gmarcus1018/USBHUB/Models/FE1.1s.STEP

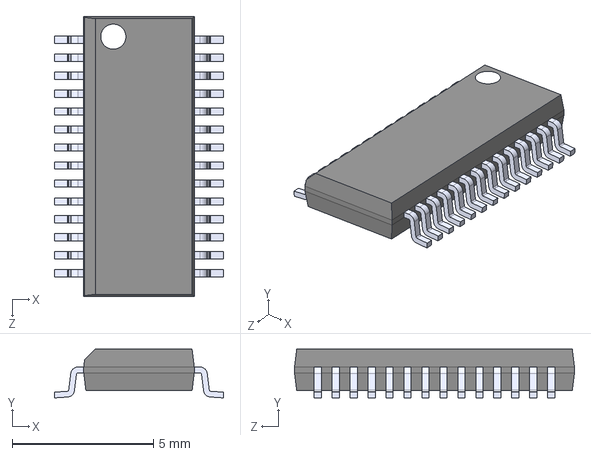
[picture p1: CAD file, 2026-06-26]
Models/FE1.1s.STEP
5.99 x 1.73 x 9.91 mm
