gmarcus1018/USBHUB/usbhub.step

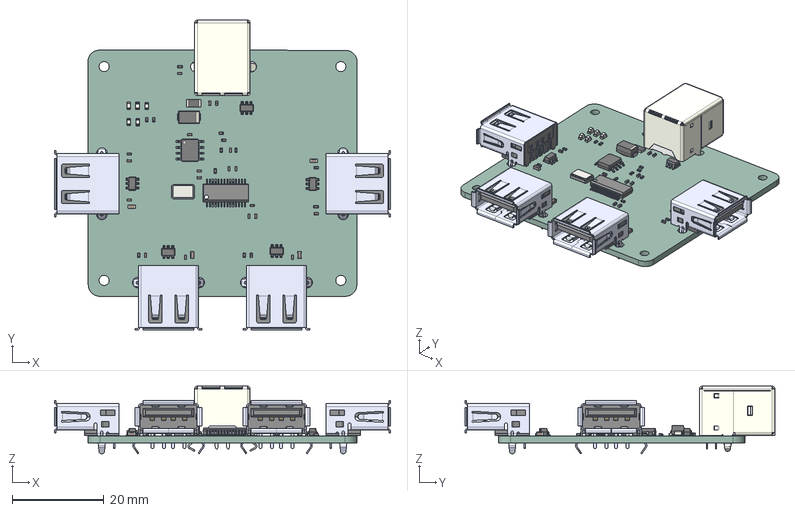
[picture p2: CAD file, 2026-06-26]
usbhub.step
73.1 x 67.4 x 14.7 mm
R_0402_1005Metric x 13
C_0402_1005Metric x 19
KUSBX-AS1N-B x 4
FE1.1S
C_0603_1608Metric x 4
SOT-23-6 x 5
LED_0603_1608Metric x 5
Fuse_1206_3216Metric
D_SMA
Crystal_SMD_Abracon_ABM3B-4Pin_5.0x3.2mm
CUI_DEVICES_UJ2-BH-W1-TH
SOIC-8-1EP_3.9x4.9mm_P1.27mm_EP2.29x3mm
usbhub_PCB
