gmarcus1018/USBHUB/Models/UJ2-BH-W1-TH.STEP

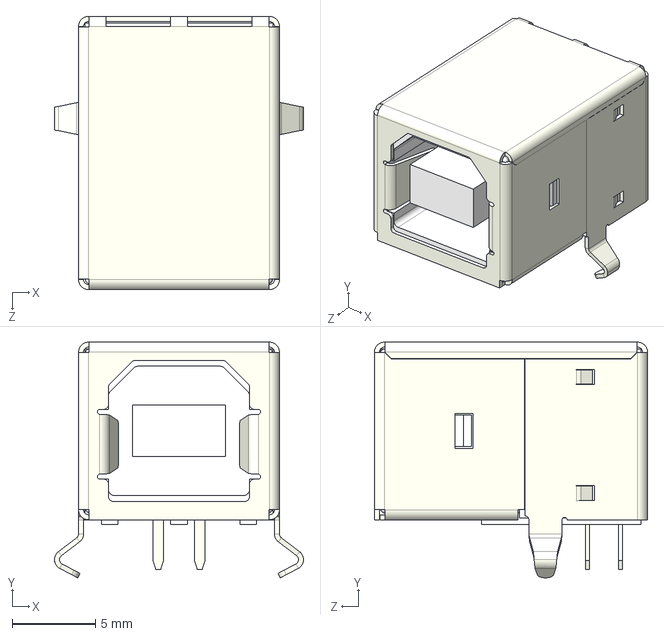
[picture p3: CAD file, 2026-06-26]
Models/UJ2-BH-W1-TH.STEP
15.0 x 14.2 x 16.5 mm
