gmarcus1018/USBHUB/Models/KUSBX-AS1N-B.STEP

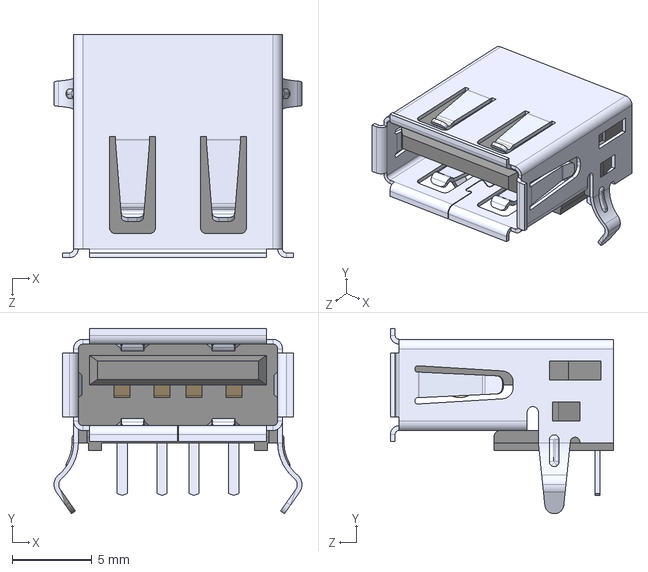
[picture p4: CAD file, 2026-06-26]
Models/KUSBX-AS1N-B.STEP
15.5 x 11.6 x 14.0 mm
