gmarcus1018/USBHUB/usbhub.kicad_pcb

## KiCad design usbhub.kicad_pcb (2026-06-26)

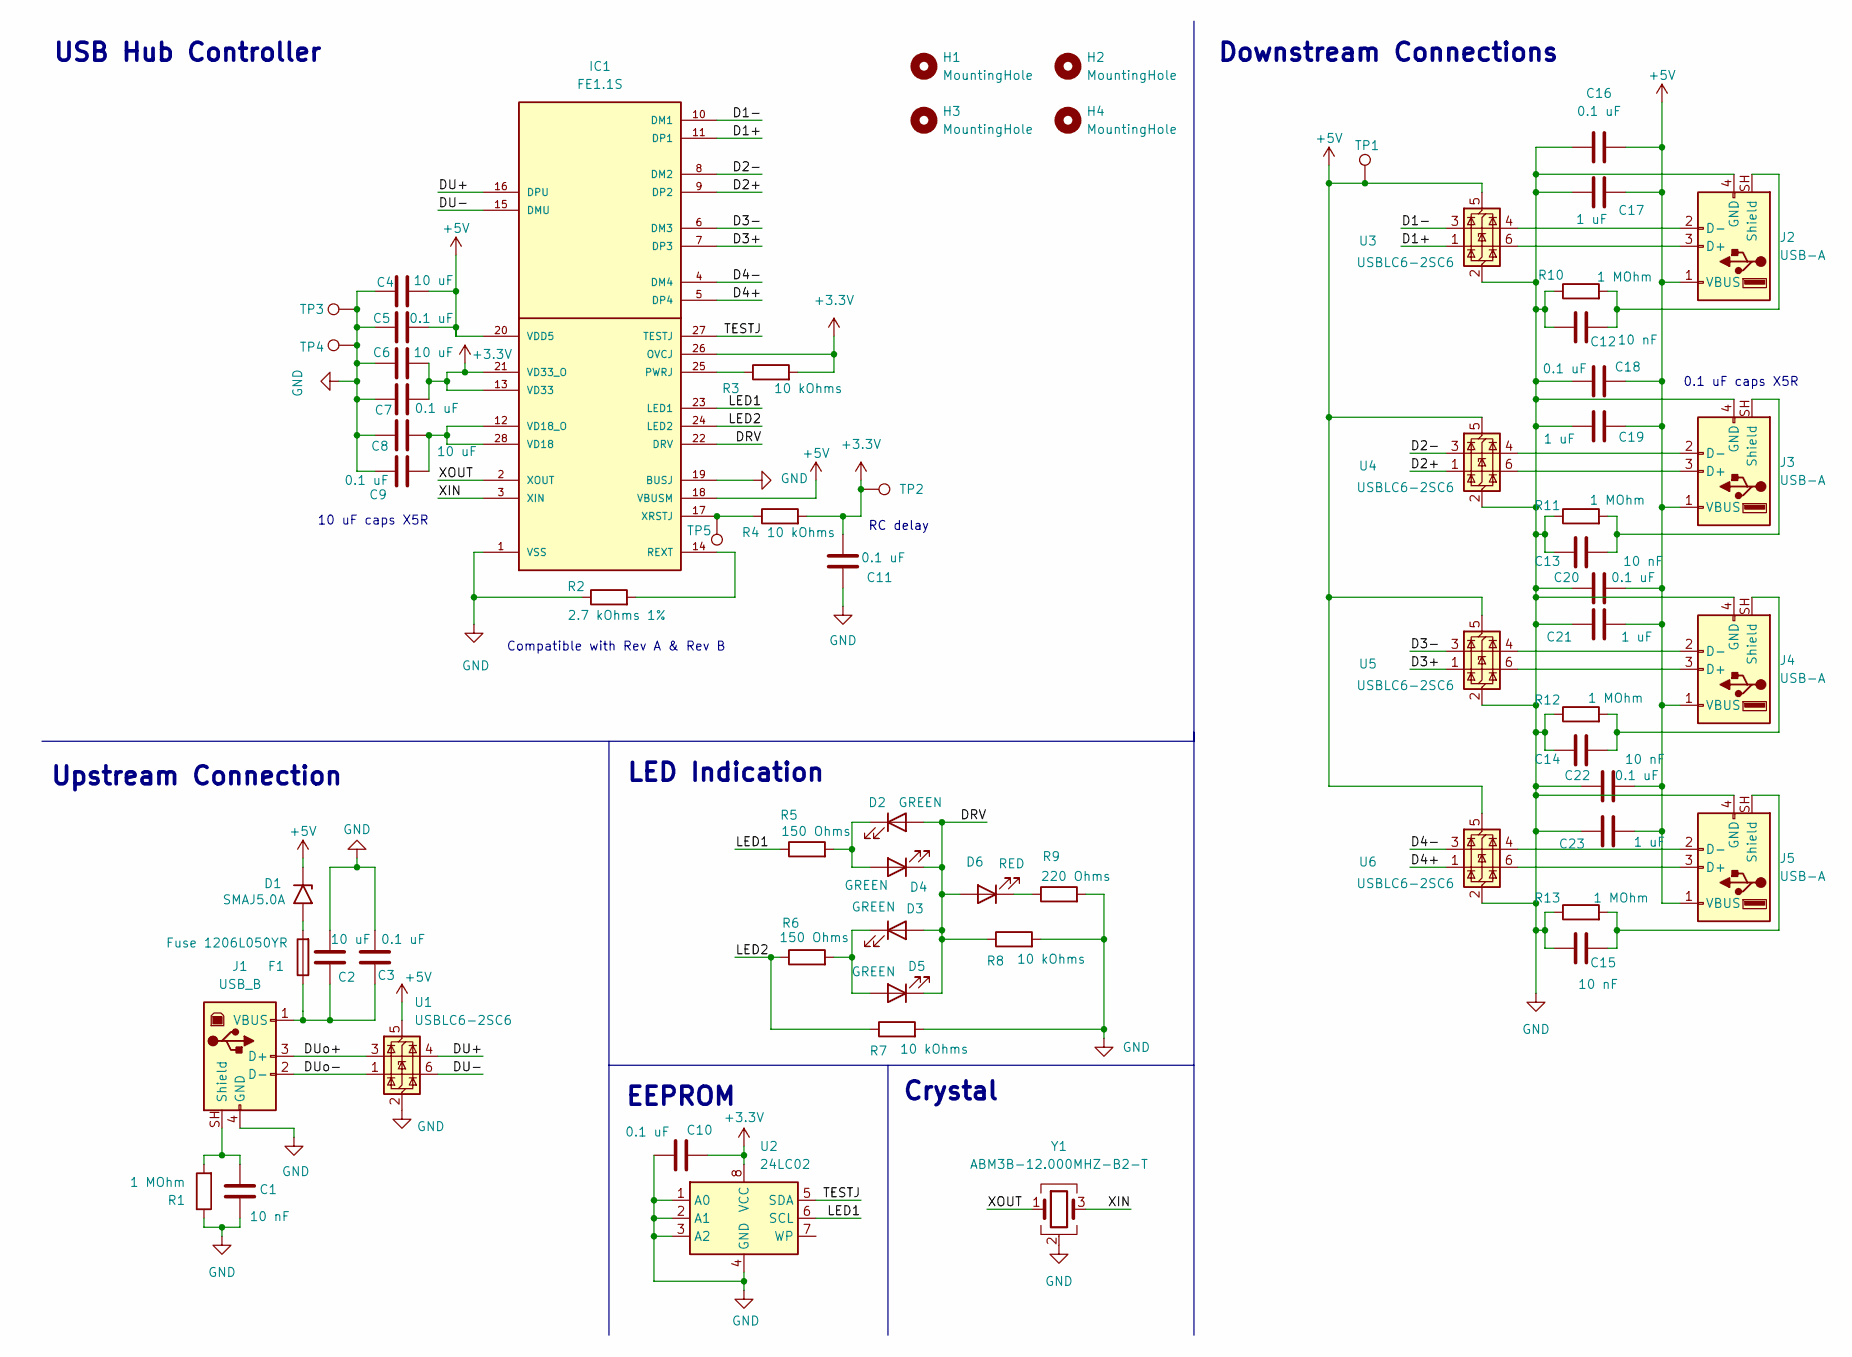
[picture p5: schematic usbhub.kicad_sch, USB Hub Project]

Parts:
C1, C12, C13, C14, C15: 10 nF; C_0402_1005Metric
C2, C4, C6, C8: 10 uF; C_0402_1005Metric
C3, C5, C7, C9, C10, C11, C16, C18, C20, C22: 0.1 uF; C_0402_1005Metric
C17, C19, C21, C23: 1 uF; C_0603_1608Metric
D1: SMAJ5.0A; D_SMA
D2, D3, D4, D5: GREEN; LED_0603_1608Metric
D6: RED; LED_0603_1608Metric
F1: Fuse 1206L050YR; Fuse_1206_3216Metric
H1, H2, H3, H4: MountingHole; MountingHole_2.2mm_M2
IC1: FE1.1S; SOP64P600X175-28N
J1: USB_B; CUI_UJ2-BH-W1-TH
J2, J3, J4, J5: USB-A; USB_A_Kycon_KUSBX-AS1N-B_Horizontal; PARTREV E
R1, R10, R11, R12, R13: 1 MOhm; R_0402_1005Metric
R2: 2.7 kOhms 1%; R_0402_1005Metric
R3, R4, R7, R8: 10 kOhms; R_0402_1005Metric
R5, R6: 150 Ohms; R_0402_1005Metric
R9: 220 Ohms; R_0402_1005Metric
TP1, TP2, TP3, TP4, TP5: TestPoint; TestPoint_Pad_D1.0mm
U1, U3, U4, U5, U6: USBLC6-2SC6; SOT-23-6
U2: 24LC02; SOIC-8-1EP_3.9x4.9mm_P1.27mm_EP2.29x3mm
Y1: ABM3B-12.000MHZ-B2-T; Crystal_SMD_Abracon_ABM3B-4Pin_5.0x3.2mm

Connections:
+3.3V: C6.2, C7.2, C10.1, C11.2, IC1.13 (VD33), IC1.21 (VD33_O), IC1.26 (OVCJ), R3.2, R4.2, TP2.1 (1_1), U2.8 (VCC)
+5V: C4.2, C5.2, C16.2, C17.2, C18.2, C19.2, C20.2, C21.2, C22.2, C23.2, D1.1 (A1), IC1.18 (VBUSM), IC1.20 (VDD5), J2.1 (VBUS), J3.1 (VBUS), J4.1 (VBUS), J5.1 (VBUS), TP1.1 (1_1), U1.5 (VBUS), U3.5 (VBUS), U4.5 (VBUS), U5.5 (VBUS), U6.5 (VBUS)
/D1+: IC1.11 (DP1), U3.1 (I/O2)
/D1-: IC1.10 (DM1), U3.3 (I/O1)
/D2+: IC1.9 (DP2), U4.1 (I/O2)
/D2-: IC1.8 (DM2), U4.3 (I/O1)
/D3+: IC1.7 (DP3), U5.1 (I/O2)
/D3-: IC1.6 (DM3), U5.3 (I/O1)
/D4+: IC1.5 (DP4), U6.1 (I/O2)
/D4-: IC1.4 (DM4), U6.3 (I/O1)
/DRV: D2.2 (A), D3.2 (A), D4.1 (K), D5.1 (K), D6.2 (A), IC1.22 (DRV), R8.1
/DU+: IC1.16 (DPU), U1.4 (I/O1)
/DU-: IC1.15 (DMU), U1.6 (I/O2)
/DUo+: J1.3 (D+), U1.3 (I/O1)
/DUo-: J1.2 (D-), U1.1 (I/O2)
/LED1: IC1.23 (LED1), R5.1, U2.6 (SCL)
/LED2: IC1.24 (LED2), R6.1, R7.1
/TESTJ: IC1.27 (TESTJ), U2.5 (SDA)
/XIN: IC1.3 (XIN), Y1.3
/XOUT: IC1.2 (XOUT), Y1.1
GND: C1.1, C2.2, C3.2, C4.1, C5.1, C6.1, C7.1, C8.1, C9.1, C10.2, C11.1, C12.1, C13.1, C14.1, C15.1, C16.1, C17.1, C18.1, C19.1, C20.1, C21.1, C22.1, C23.1, IC1.1 (VSS), IC1.19 (BUSJ), J1.4 (GND), J2.4 (GND), J3.4 (GND), J4.4 (GND), J5.4 (GND), R1.1, R2.1, R7.2, R8.2, R9.2, R10.1, R11.1, R12.1, R13.1, TP3.1 (1_1), TP4.1 (1_1), U1.2 (GND), U2.1 (A0), U2.2 (A1), U2.3 (A2), U2.4 (GND), U3.2 (GND), U4.2 (GND), U5.2 (GND), U6.2 (GND), Y1.2 (G), Y1.4 (G)
unnamed: D1.2 (A2), F1.2
unnamed: D2.1 (K), D4.2 (A), R5.2
unnamed: D3.1 (K), D5.2 (A), R6.2
unnamed: D6.1 (K), R9.1
unnamed: IC1.25 (PWRJ), R3.1
unnamed: IC1.14 (REXT), R2.2
unnamed: C8.2, C9.2, IC1.12 (VD18_O), IC1.28 (VD18)
unnamed: IC1.17 (XRSTJ), R4.1, TP5.1 (1_1)
unnamed: C1.2, J1.SH (Shield), R1.2
unnamed: C2.1, C3.1, F1.1, J1.1 (VBUS)
unnamed: J2.3 (D+), U3.6 (I/O2)
unnamed: J2.2 (D-), U3.4 (I/O1)
unnamed: C12.2, J2.SH (Shield), R10.2
unnamed: J3.3 (D+), U4.6 (I/O2)
unnamed: J3.2 (D-), U4.4 (I/O1)
unnamed: C13.2, J3.SH (Shield), R11.2
unnamed: J4.3 (D+), U5.6 (I/O2)
unnamed: J4.2 (D-), U5.4 (I/O1)
unnamed: C14.2, J4.SH (Shield), R12.2
unnamed: J5.3 (D+), U6.6 (I/O2)
unnamed: J5.2 (D-), U6.4 (I/O1)
unnamed: C15.2, J5.SH (Shield), R13.2

Notes on the sheet:
Compatible with Rev A & Rev B
RC delay
EEPROM
0.1 uF caps X5R
10 uF caps X5R
USB Hub Controller
LED Indication
Upstream Connection
Downstream Connections
Crystal

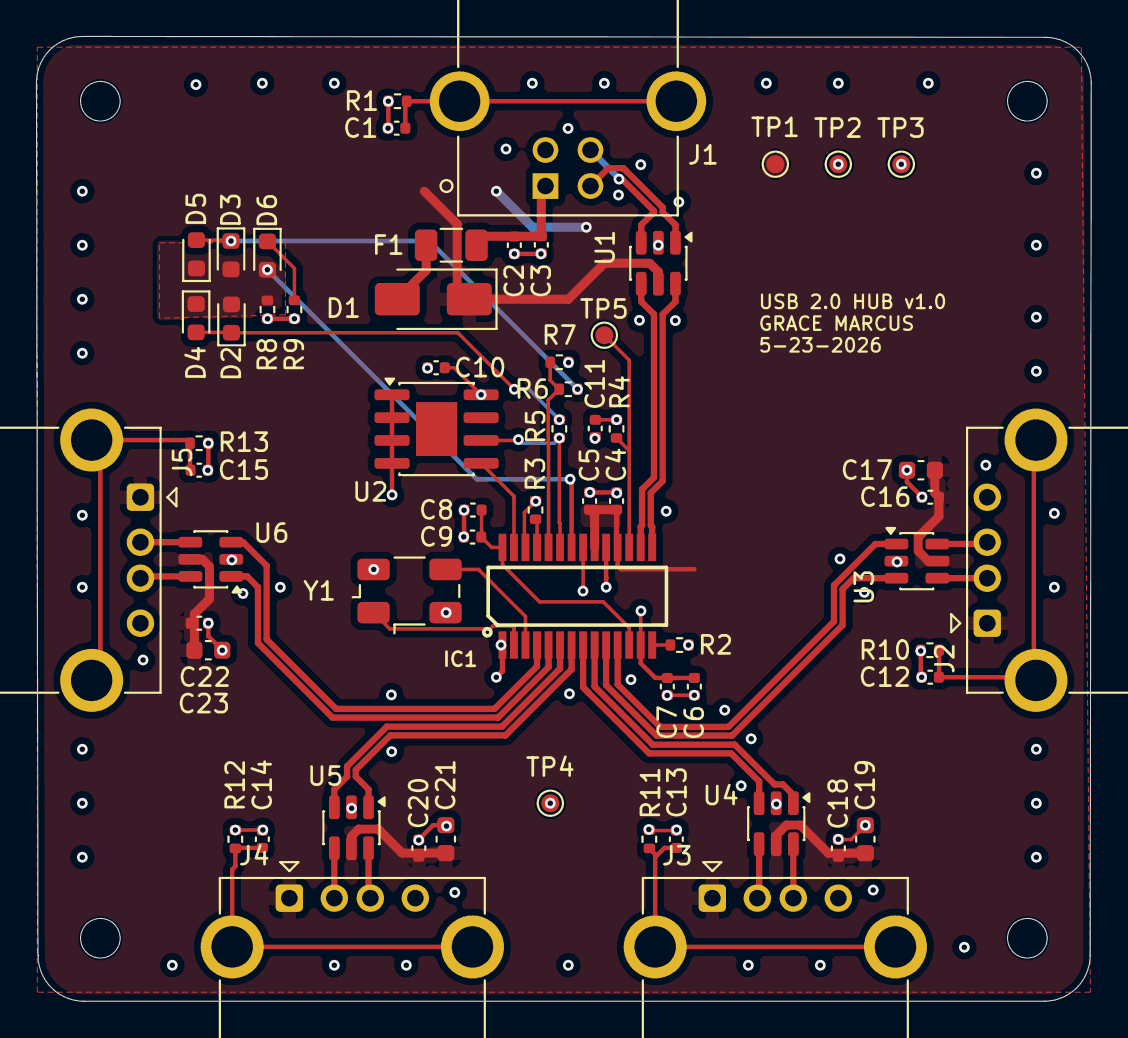
[picture p6: board usbhub.kicad_pcb from above]

Board: 4 copper layers, 58.6 x 53.6 mm, 65 parts (0 on the bottom side), 43 nets.
