gmarcus1018/USBHUB/(commit log)

2026-06-19 USB connectors 3D model update
    [KUSBX-AS1N-B.STEP, UJ2-BH-W1-TH.STEP, usbhub.kicad_pcb, usbhub.kicad_sch, usbhub.step]
2026-06-20 add FE1.1s 3D model
    [FE1.1s.STEP, usbhub.kicad_pcb, usbhub.step]
2026-06-26 X7R -> X5R
    [usbhub.csv, usbhub.kicad_sch]
